MG-5/usb-c-to-liion-charger/usb-c-to-liion-charger.kicad_pcb

## KiCad design usb-c-to-liion-charger.kicad_pcb (2023-03-08)

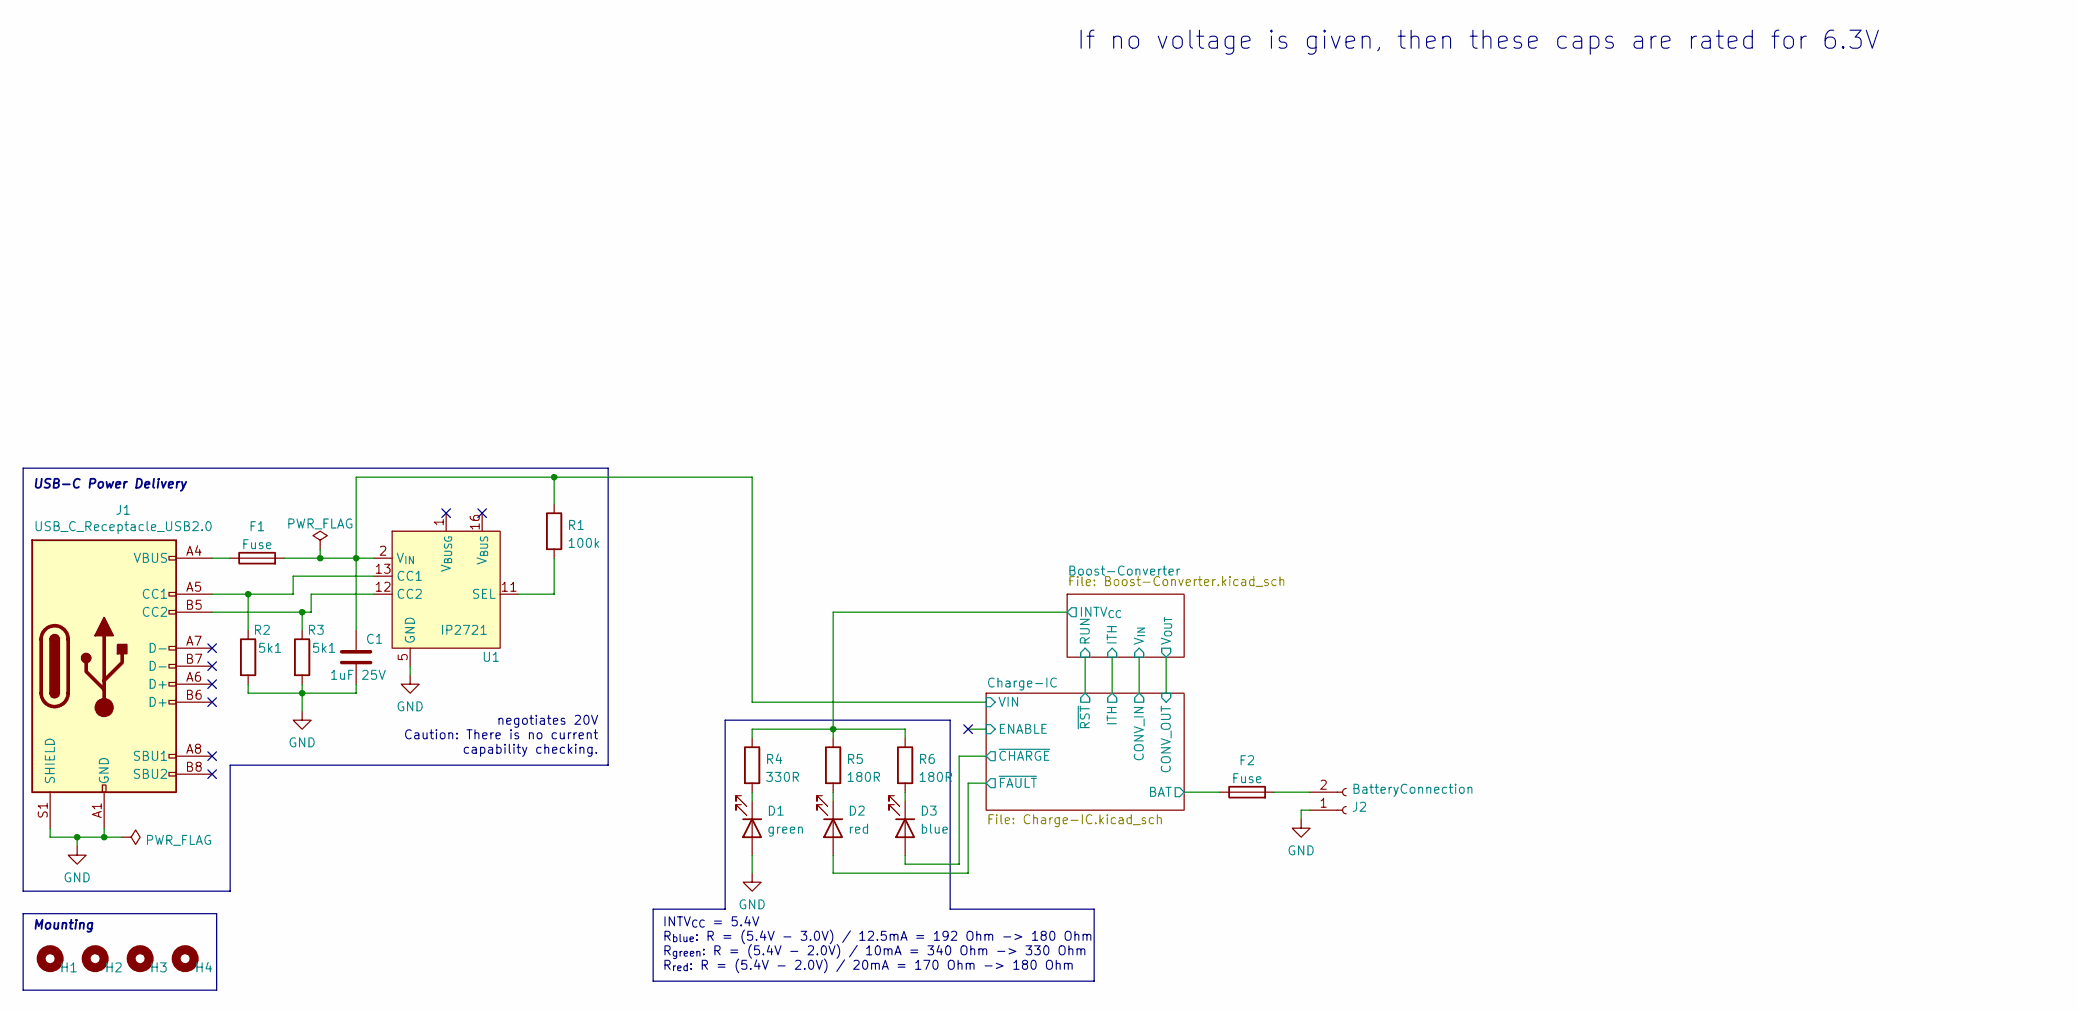
[picture p1: schematic usb-c-to-liion-charger.kicad_sch]

Parts:
C1: 1uF 25V; C_0603_1608Metric
D1: green; LED_0603_1608Metric
D2: red; LED_0603_1608Metric
D3: blue; LED_0603_1608Metric
F1, F2: Fuse; KEYSTONE-FUSE-3557-2
H1, H2, H3, H4: MountingHole_3.2mm_M3_ISO7380_Keepout
J1: USB_C_Receptacle_USB2.0; USB_C_Receptacle_Palconn_UTC16-G
J2: BatteryConnection; AMASS_XT30U-M_1x02_P5.0mm_Vertical
R1: 100k; R_0603_1608Metric
R2, R3: 5k1; R_0603_1608Metric
R4: 330R; R_0603_1608Metric
R5, R6: 180R; R_0603_1608Metric
U1: IP2721; TSSOP-16_4.4x5mm_P0.65mm

Connections:
/Boost-Converter/INTV_{CC}: R4.1, R5.1, R6.1; also elsewhere on the board
/Charge-IC/BAT: F2.1; also elsewhere on the board
/Charge-IC/VIN: C1.1, F1.2, R1.1, U1.2 (V_{IN}); also elsewhere on the board
/Charge-IC/~CHARGE: D3.2 (A); also elsewhere on the board
/Charge-IC/~FAULT: D2.2 (A); also elsewhere on the board
GND: C1.2, D1.2 (A), J1.A1 (GND), J1.A12 (GND), J1.B1 (GND), J1.B12 (GND), J1.S1 (SHIELD), J2.1, R2.2, R3.2, U1.5 (GND); also elsewhere on the board
unnamed: D1.1 (K), R4.2
unnamed: D2.1 (K), R5.2
unnamed: D3.1 (K), R6.2
unnamed: F1.1, J1.A4 (VBUS), J1.A9 (VBUS), J1.B4 (VBUS), J1.B9 (VBUS)
unnamed: J1.A5 (CC1), R2.1, U1.13 (CC1)
unnamed: J1.B5 (CC2), R3.1, U1.12 (CC2)
unnamed: F2.2, J2.2
unnamed: R1.2, U1.11 (SEL)

Notes on the sheet:
USB-C Power Delivery
If no voltage is given, then these caps are rated for 6.3V
negotiates 20V Caution: There is no current capability checking.
Mounting
INTV_{CC} = 5.4V R_{blue}: R = (5.4V - 3.0V) / 12.5mA = 192 Ohm -> 180 Ohm R_{green}: R = (5.4V - 2.0V) / 10mA = 340 Ohm -> 330 Ohm R_{red}: R = (5.4V - 2.0V) / 20mA = 170 Ohm -> 180 Ohm

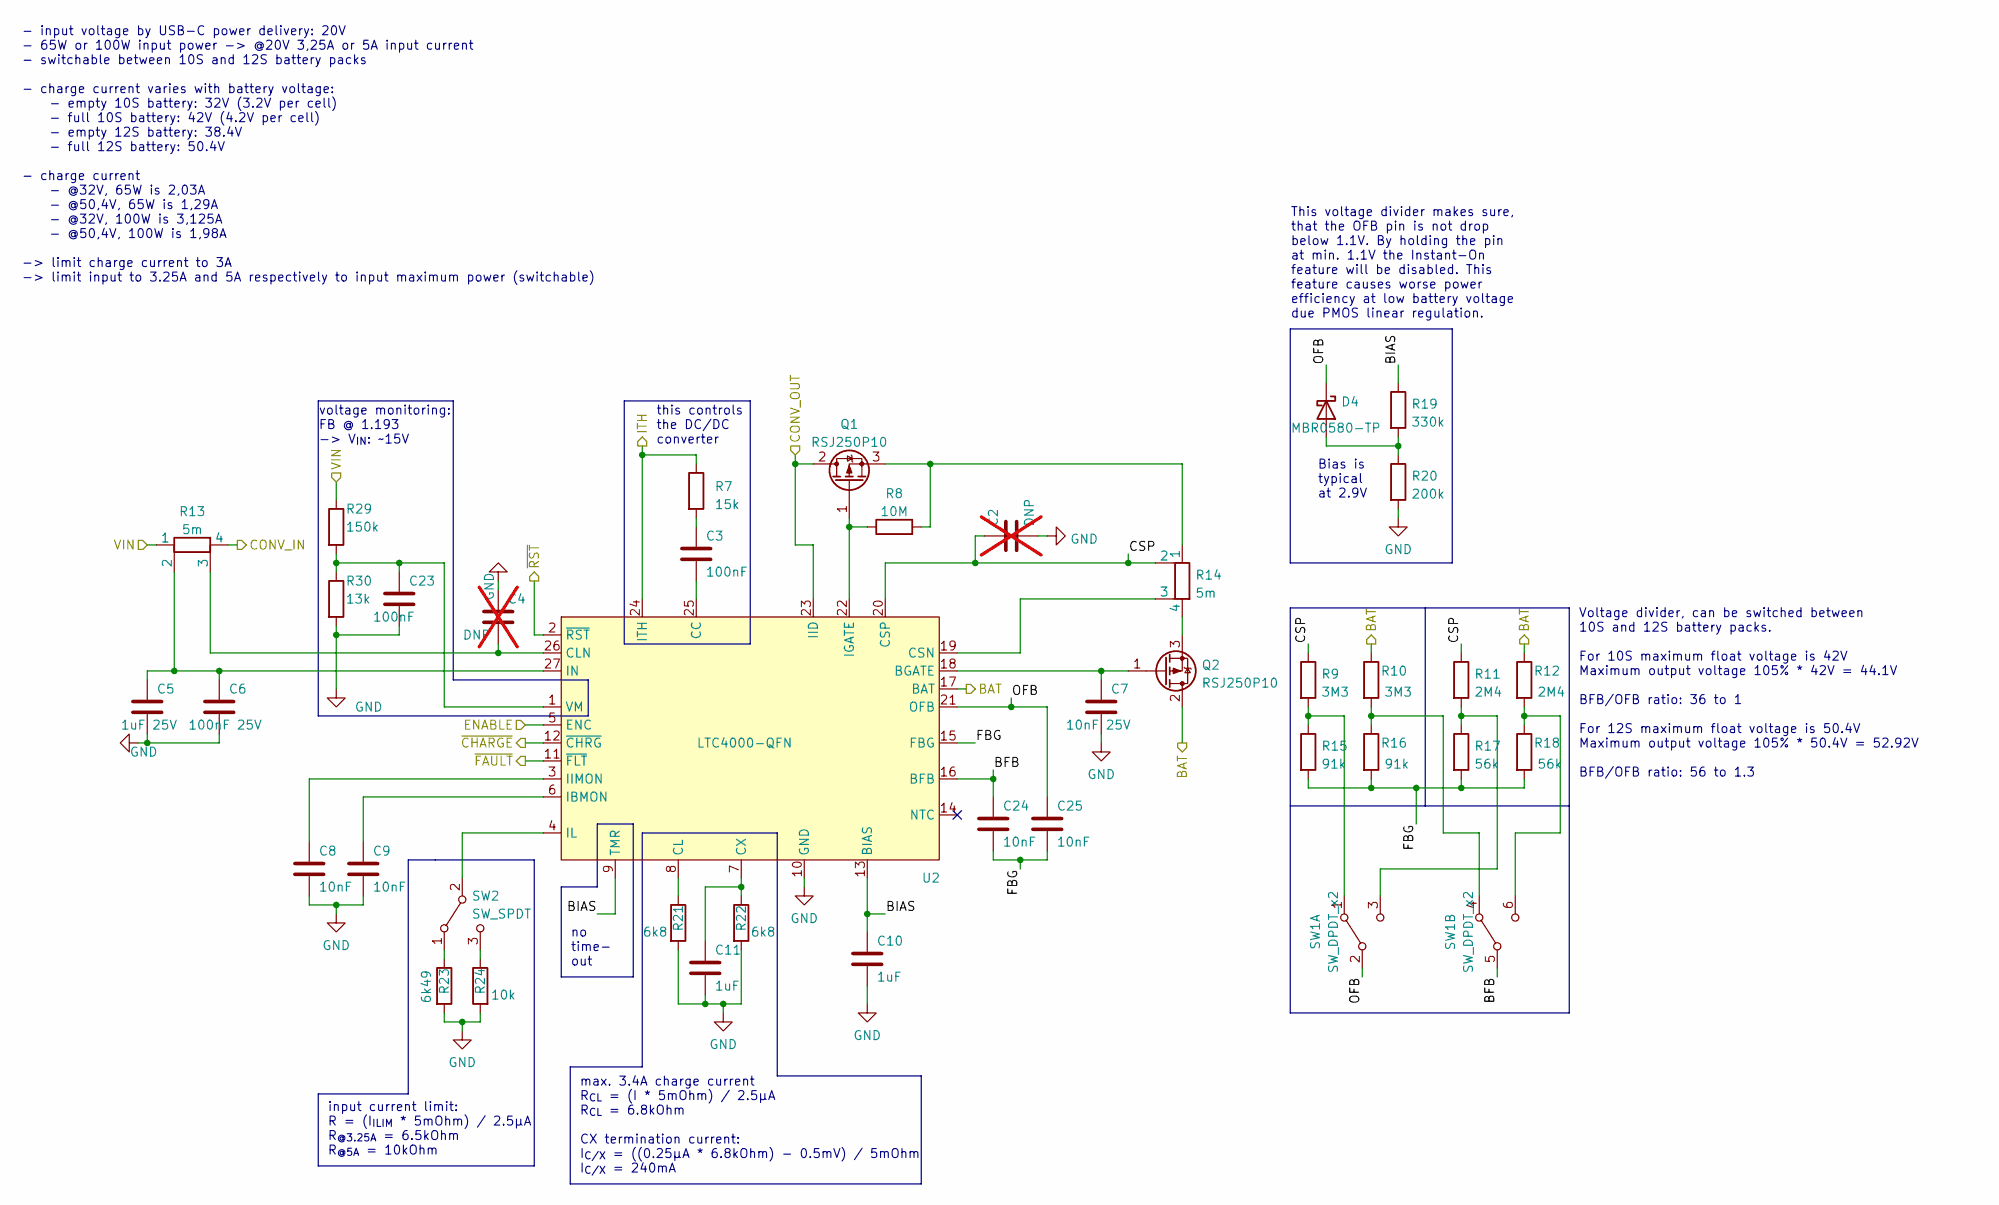
[picture p2: schematic Charge-IC.kicad_sch]

Parts:
C2, C4: DNP; C_0603_1608Metric; not fitted
C3, C23: 100nF; C_0603_1608Metric
C5: 1uF 25V; C_0603_1608Metric
C6: 100nF 25V; C_0603_1608Metric
C7: 10nF 25V; C_0603_1608Metric
C8, C9, C24, C25: 10nF; C_0603_1608Metric
C10, C11: 1uF; C_0603_1608Metric
D4: MBR0580-TP; D_SOD-123
Q1, Q2: RSJ250P10; TO-263-2
R7: 15k; R_0603_1608Metric
R8: 10M; R_0603_1608Metric
R9, R10: 3M3; R_0603_1608Metric
R11, R12: 2M4; R_0603_1608Metric
R13, R14: 5m; R_0805_2012Metric_4Kelvin
R15, R16: 91k; R_0603_1608Metric
R17, R18: 56k; R_0603_1608Metric
R19: 330k; R_0603_1608Metric
R20: 200k; R_0603_1608Metric
R21, R22: 6k8; R_0603_1608Metric
R23: 6k49; R_0603_1608Metric
R24: 10k; R_0603_1608Metric
R29: 150k; R_0603_1608Metric
R30: 13k; R_0603_1608Metric
SW1: SW_DPDT_x2; SW_E-Switch_EG2201_DPDT
SW2: SW_SPDT; SW_E-Switch_EG1249_SPDT
U2: LTC4000-QFN; QFN-28-1EP_4x5mm_P0.5mm_EP2.65x3.65mm_ThermalVias

Connections:
/Boost-Converter/ITH: R7.1, U2.24 (ITH); also elsewhere on the board
/Boost-Converter/RUN: U2.2 (~RST); also elsewhere on the board
/Boost-Converter/V_{IN}: R13.4; also elsewhere on the board
/Boost-Converter/V_{OUT}: Q1.2 (D), U2.23 (IID); also elsewhere on the board
/Charge-IC/BAT: Q2.2 (D), R10.1, R12.1, U2.17 (BAT); also elsewhere on the board
/Charge-IC/BFB: C24.1, SW1.5 (B), U2.16 (BFB)
/Charge-IC/BIAS: C10.1, R19.1, U2.9 (TMR), U2.13 (BIAS)
/Charge-IC/CSP: C2.1, R9.1, R11.1, R14.2, U2.20 (CSP)
/Charge-IC/ENABLE: U2.5 (ENC)
/Charge-IC/FBG: C24.2, C25.2, R15.2, R16.2, R17.2, R18.2, U2.15 (FBG)
/Charge-IC/OFB: C25.1, D4.1 (K), SW1.2 (B), U2.21 (OFB)
/Charge-IC/VIN: R13.1, R29.1; also elsewhere on the board
/Charge-IC/~CHARGE: U2.12 (~CHRG); also elsewhere on the board
/Charge-IC/~FAULT: U2.11 (~FLT); also elsewhere on the board
GND: C2.2, C4.1, C5.2, C6.2, C7.2, C8.2, C9.2, C10.2, C11.2, C23.2, R20.2, R21.2, R22.2, R23.2, R24.2, R30.2, U2.10 (GND), U2.28 (GND), U2.29 (GND); also elsewhere on the board
unnamed: C3.1, R7.2
unnamed: D4.2 (A), R19.2, R20.1
unnamed: Q1.1 (G), R8.1, U2.22 (IGATE)
unnamed: Q1.3 (S), R8.2, R14.1
unnamed: C7.1, Q2.1 (G), U2.18 (BGATE)
unnamed: Q2.3 (S), R14.4
unnamed: R9.2, R15.1, SW1.1 (A)
unnamed: R11.2, R17.1, SW1.3 (C)
unnamed: R10.2, R16.1, SW1.4 (A)
unnamed: R12.2, R18.1, SW1.6 (C)
unnamed: R23.1, SW2.1 (A)
unnamed: SW2.2 (B), U2.4 (IL)
unnamed: R24.1, SW2.3 (C)
unnamed: C3.2, U2.25 (CC)
unnamed: R21.1, U2.8 (CL)
unnamed: C4.2, R13.3, U2.26 (CLN)
unnamed: R14.3, U2.19 (CSN)
unnamed: C11.1, R22.1, U2.7 (CX)
unnamed: C9.1, U2.6 (IBMON)
unnamed: C8.1, U2.3 (IIMON)
unnamed: C5.1, C6.1, R13.2, U2.27 (IN)
unnamed: C23.1, R29.2, R30.1, U2.1 (VM)

Notes on the sheet:
no time- out
max. 3.4A charge current R_{CL} = (I * 5mOhm) / 2.5µA R_{CL} = 6.8kOhm CX termination current: I_{C/X} = ((0.25µA * 6.8kOhm) - 0.5mV) / 5mOhm I_{C/X} = 240mA
Voltage divider, can be switched between 10S and 12S battery packs. For 10S maximum float voltage is 42V Maximum output voltage 105% * 42V = 44.1V BFB/OFB ratio: 36 to 1 For 12S maximum float voltage is 50.4V Maximum output voltage 105% * 50.4V = 52.92V BFB/OFB ratio: 56 to 1.3
This voltage divider makes sure, that the OFB pin is not drop below 1.1V. By holding the pin at min. 1.1V the Instant-On feature will be disabled. This feature causes worse power efficiency at low battery voltage due PMOS linear regulation.
Bias is typical at 2.9V
this controls the DC/DC converter
voltage monitoring: FB @ 1.193 -> V_{IN}: ~15V
input current limit: R = (I_{ILIM} * 5mOhm) / 2.5µA R_{@3.25A} = 6.5kOhm R_{@5A} = 10kOhm
- input voltage by USB-C power delivery: 20V - 65W or 100W input power -> @20V 3,25A or 5A input current - switchable between 10S and 12S battery packs - charge current varies with battery voltage: - empty 10S battery: 32V (3.2V per cell) - full 10S battery: 42V (4.2V per cell) - empty 12S battery: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

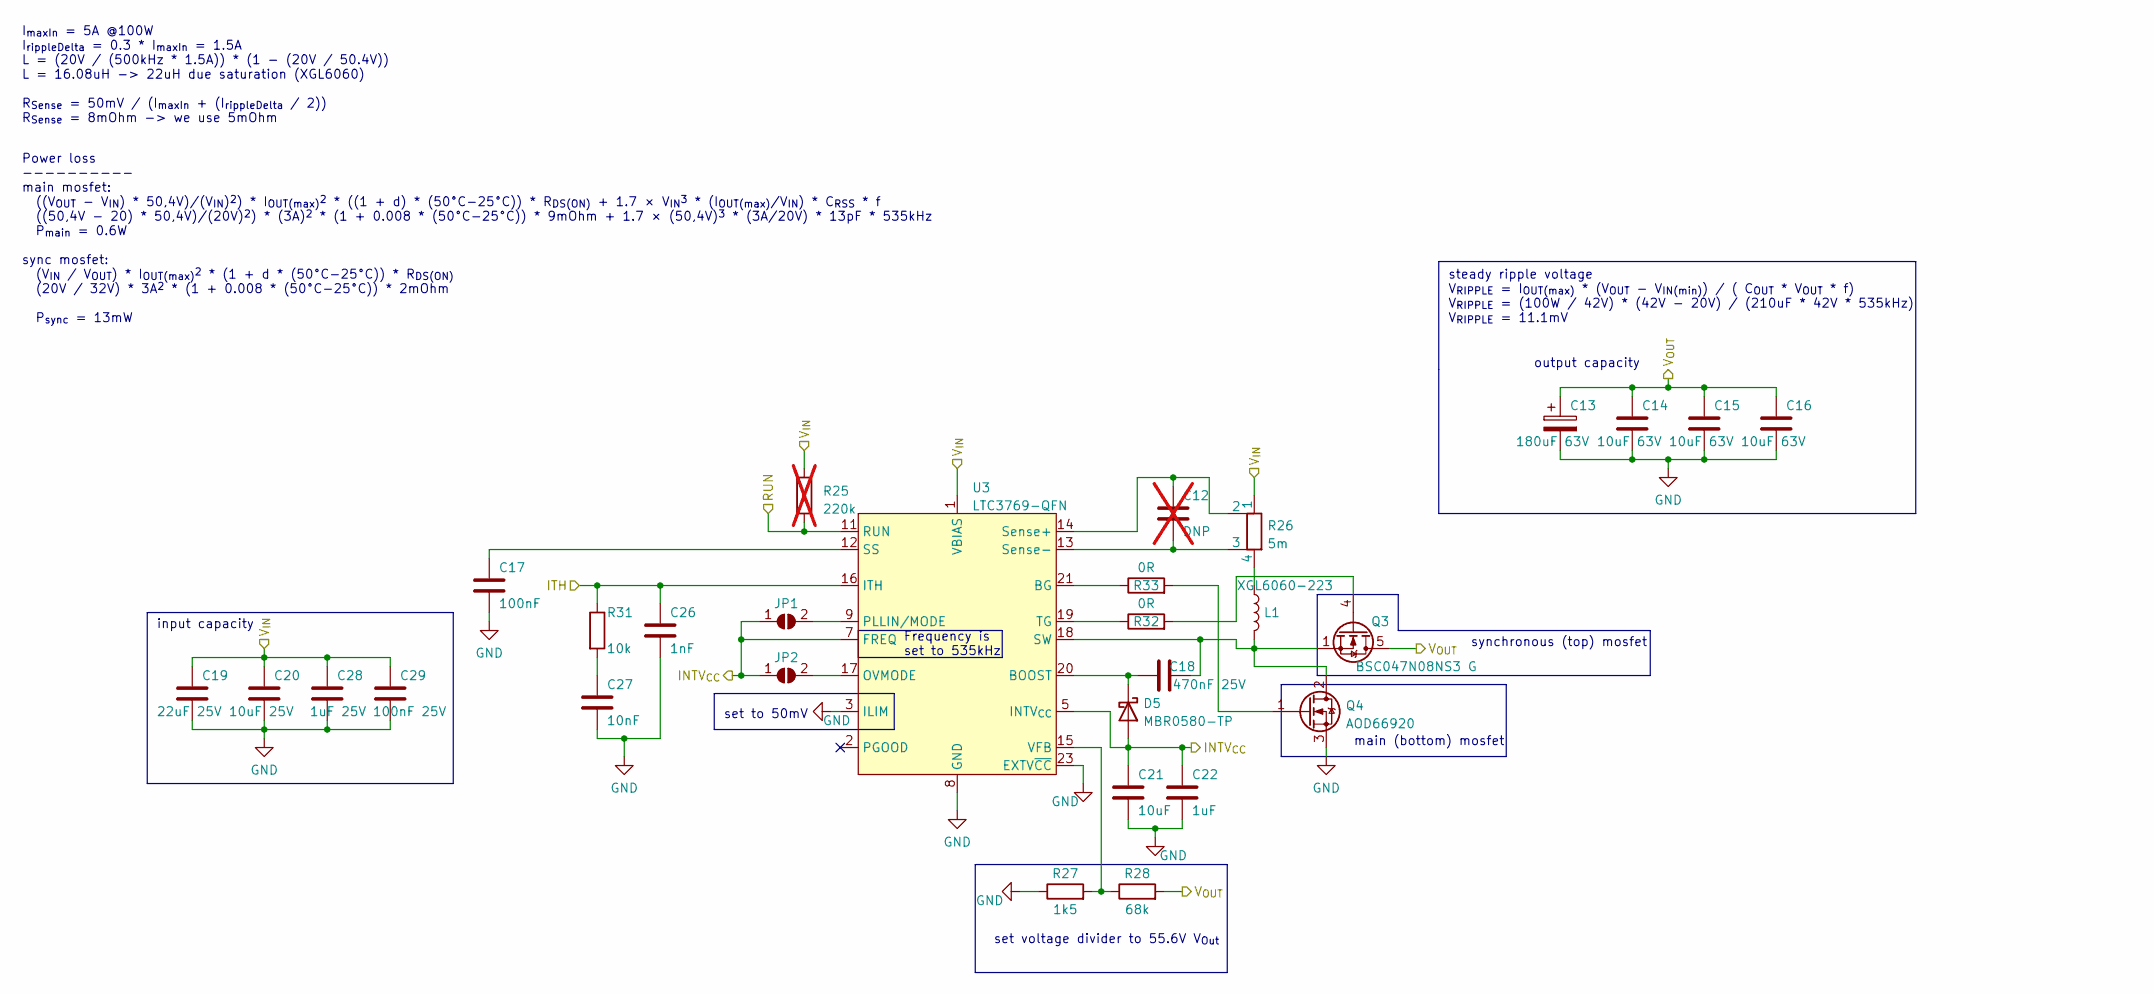
[picture p3: schematic Boost-Converter.kicad_sch]

Parts:
C12: DNP; C_0603_1608Metric; not fitted
C13: 180uF 63V; CP_Radial_D10.0mm_P5.00mm
C14, C15, C16: 10uF 63V; C_1210_3225Metric
C17: 100nF; C_0603_1608Metric
C18: 470nF 25V; C_0603_1608Metric
C19: 22uF 25V; C_0805_2012Metric
C20: 10uF 25V; C_0805_2012Metric
C21: 10uF; C_0805_2012Metric
C22: 1uF; C_0603_1608Metric
C26: 1nF; C_0603_1608Metric
C27: 10nF; C_0603_1608Metric
C28: 1uF 25V; C_0805_2012Metric
C29: 100nF 25V; C_0805_2012Metric
D5: MBR0580-TP; D_SOD-123
JP1, JP2: SolderJumper_2_Open; SolderJumper-Open_0603
L1: XGL6060-223; L_Coilcraft_XAL6060-XXX
Q3: BSC047N08NS3 G; TDSON-8-1
Q4: AOD66920; TO-252-3_TabPin2
R25: 220k; R_0603_1608Metric; not fitted
R26: 5m; R_0805_2012Metric_4Kelvin
R27: 1k5; R_0603_1608Metric
R28: 68k; R_0603_1608Metric
R31: 10k; R_0603_1608Metric
R32, R33: 0R; R_0603_1608Metric
U3: LTC3769-QFN; WQFN-24-1EP_4x4mm_P0.5mm_EP2.45x2.45mm_ThermalVias

Connections:
/Boost-Converter/INTV_{CC}: C21.1, C22.1, D5.2 (A), JP1.1 (A), JP2.1 (A), U3.5 (INTV_{CC}), U3.7 (FREQ), U3.22 (INTV_{CC}); also elsewhere on the board
/Boost-Converter/ITH: C26.1, R31.1, U3.16 (ITH); also elsewhere on the board
/Boost-Converter/RUN: R25.2, U3.11 (RUN); also elsewhere on the board
/Boost-Converter/V_{IN}: C19.1, C20.1, C28.1, C29.1, R25.1, R26.1, U3.1 (VBIAS); also elsewhere on the board
/Boost-Converter/V_{OUT}: C13.1, C14.1, C15.1, C16.1, Q3.5 (D), R28.2; also elsewhere on the board
GND: C13.2, C14.2, C15.2, C16.2, C17.2, C19.2, C20.2, C21.2, C22.2, C26.2, C27.2, C28.2, C29.2, Q4.3 (S), R27.1, U3.3 (ILIM), U3.8 (GND), U3.10 (GND), U3.23 (EXTV~CC), U3.24 (GND), U3.25 (GND); also elsewhere on the board
unnamed: C27.1, R31.2
unnamed: C18.2, D5.1 (K), U3.20 (BOOST)
unnamed: JP1.2 (B), U3.9 (PLLIN/MODE)
unnamed: JP2.2 (B), U3.17 (OVMODE)
unnamed: L1.1, R26.4
unnamed: Q3.4 (G), R32.2
unnamed: C18.1, L1.2, Q3.1 (S), Q3.2 (S), Q3.3 (S), Q4.2 (D), U3.18 (SW)
unnamed: Q4.1 (G), R33.2
unnamed: R33.1, U3.21 (BG)
unnamed: C17.1, U3.12 (SS)
unnamed: C12.1, R26.2, U3.14 (Sense+)
unnamed: C12.2, R26.3, U3.13 (Sense-)
unnamed: R32.1, U3.19 (TG)
unnamed: R27.2, R28.1, U3.15 (VFB)

Notes on the sheet:
Power loss ---------- main mosfet: ((V_{OUT} − V_{IN}) * 50,4V)/(V_{IN})^{2}) * I_{OUT(max)}^{2} * ((1 + d) * (50°C-25°C)) * R_{DS(ON)} + 1.7 × V_{IN}^{3} * (I_{OUT(max)}/V_{IN}) * C_{RSS} * f ((50,4V − 20) * 50,4V)/(20V)^{2}) * (3A)^{2} * (1 + 0.008 * (50°C-25°C)) * 9mOhm + 1.7 × (50,4V)^{3} * (3A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
steady ripple voltage V_{RIPPLE} = I_{OUT(max)} * (V_{OUT} - V_{IN(min)}) / ( C_{OUT} * V_{OUT} * f) V_{RIPPLE} = (100W / 42V) * (42V - 20V) / (210uF * 42V * 535kHz) V_{RIPPLE} = 11.1mV
I_{maxIn} = 5A @100W I_{rippleDelta} = 0.3 * I_{maxIn} = 1.5A L = (20V / (500kHz * 1.5A)) * (1 - (20V / 50.4V)) L = 16.08uH -> 22uH due saturation (XGL6060) R_{Sense} = 50mV / (I_{maxIn} + (I_{rippleDelta} / 2)) R_{Sense} = 8mOhm -> we use 5mOhm
input capacity
output capacity
main (bottom) mosfet
set to 50mV
set voltage divider to 55.6V V_{Out}
Frequency is set to 535kHz
synchronous (top) mosfet

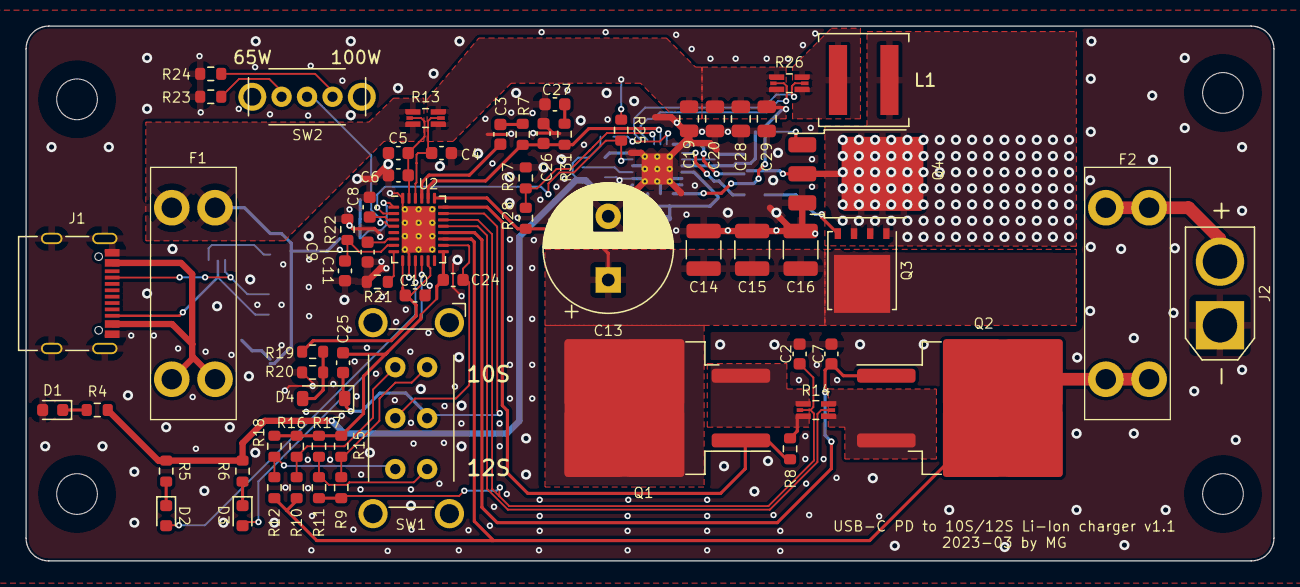
[picture p4: board usb-c-to-liion-charger.kicad_pcb from above]

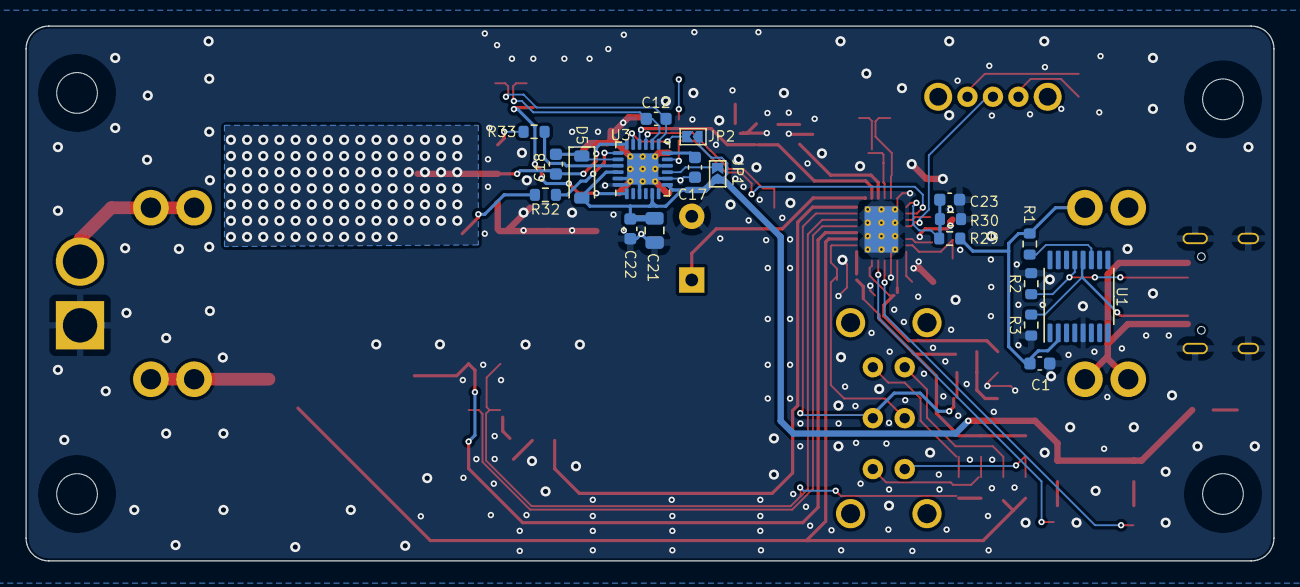
[picture p5: board usb-c-to-liion-charger.kicad_pcb from below]

Board: 2 copper layers, 98.0 x 42.0 mm, 87 parts (19 on the bottom side), 59 nets.
