MG-5/usb-c-to-liion-charger/(commit log)

2022-02-21 Update to KiCad 6.0.2
    [usb-c-to-liion-charger.kicad_sch, usb-c-to-liion-charger.sch]
2022-03-24 Add LTC4000 and LTC3789
    [usb-c-to-liion-charger.kicad_sch]
2022-03-30 WIP charge IC
    [Charge-IC.kicad_sch, usb-c-to-liion-charger.kicad_sch]
2022-03-30 Finish Charge IC, WIP boost converter, add LTC3769
    [Boost-Converter.kicad_sch, Charge-IC.kicad_sch, usb-c-to-liion-charger.kicad_sch]
2022-04-01 WIP boost converter
    [Boost-Converter.kicad_sch, Charge-IC.kicad_sch, usb-c-to-liion-charger.kicad_sch]
2022-04-01 Finish boost converter
    [Boost-Converter.kicad_sch, Charge-IC.kicad_sch, usb-c-to-liion-charger.kicad_sch]
2022-04-04 Finish schematic
    [Boost-Converter.kicad_sch, Charge-IC.kicad_sch, usb-c-to-liion-charger.kicad_sch]
2022-04-04 Small changes
    [Boost-Converter.kicad_sch, Charge-IC.kicad_sch, usb-c-to-liion-charger.kicad_sch]
2022-04-07 Annotate symbols and assign footprints
    [Boost-Converter.kicad_sch, Charge-IC.kicad_sch, usb-c-to-liion-charger.kicad_sch]
2022-04-07 Add mounting holes
    [usb-c-to-liion-charger.kicad_sch]
2022-04-09 [WIP] Start PCB
    [usb-c-to-liion-charger.kicad_pcb, usb-c-to-liion-charger.kicad_sch]
2022-05-10 Finish PCB
    [usb-c-to-liion-charger.kicad_pcb]
2022-05-16 Optimize ground vias
    [usb-c-to-liion-charger.kicad_pcb]
2022-05-16 Add BOM
2022-05-16 Update BOM due component order
    [Boost-Converter.kicad_sch, Charge-IC.kicad_sch, usb-c-to-liion-charger.kicad_pcb, usb-c-to-liion-charger.kicad_sch]
2022-05-22 Add settings for Gerber
    [usb-c-to-liion-charger.kicad_pcb]
2023-03-03 Update to KiCad 7
    [Boost-Converter.kicad_sch, Charge-IC.kicad_sch, usb-c-to-liion-charger.kicad_pcb, usb-c-to-liion-charger.kicad_sch]
2023-03-04 Fix wrong battery polarity Enable voltage monitoring at 15V Add caps to OFB and BFB Use another diodes Replace 1206 shunt with 0805 Replace main mosfet with bigger one Improve traces/ground planes
    [Boost-Converter.kicad_sch, Charge-IC.kicad_sch, usb-c-to-liion-charger.kicad_pcb, usb-c-to-liion-charger.kicad_sch]
2023-03-04 Update BOM to v1.1
2023-03-08 Small changes due gerber export
    [usb-c-to-liion-charger.kicad_pcb]
2023-06-14 Add notes for lower switching frequency
    [Boost-Converter.kicad_sch]
